kekesjtu/hfss-agent-project3/output/README.md

# 当前交付物

当前候选为 [Project3_fabrication_R3](Project3_fabrication_R3/README_制造状态.md)。目录包含原生 PCB、HFSS 工程与导出数据、制造文件、装配模型、采购清单及自包含生成脚本。

裸板上传包为 [Project3_R3_JLC_Gerber.zip](Project3_fabrication_R3/Project3_R3_JLC_Gerber.zip)，完整操作见 [购买清单与网页图解](Project3_fabrication_R3/立创商城购买清单.md)，工艺要求见 [PCB 订购说明](Project3_fabrication_R3/PCB_订购说明.md)。板厂回签与首板实测尚未完成，不能直接视为生产放行。
