kekesjtu/hfss-agent-project3/output/Project3_fabrication_R3/BOM.csv

Reference | Quantity | Manufacturer | MPN | Description | Assembly
J1 | 1 | Wurth Elektronik | 60312202114509 | 50 ohm SMA female end launch; 1.6 mm PCB | Solder center and four ground feet; no stencil
