kekesjtu/hfss-agent-project3/output/Project3_fabrication_R3/assembly.step

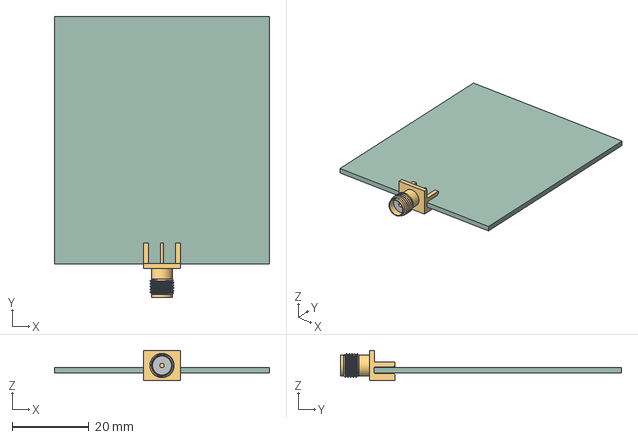
[picture p15: CAD file, 2026-11-02]
output/Project3_fabrication_R3/assembly.step
56.0 x 73.2 x 7.92 mm
60312202114509_transformed
Project3_array_R3_PCB
