kekesjtu/hfss-agent-project3/output/Project3_fabrication_R3/board_mechanical.step

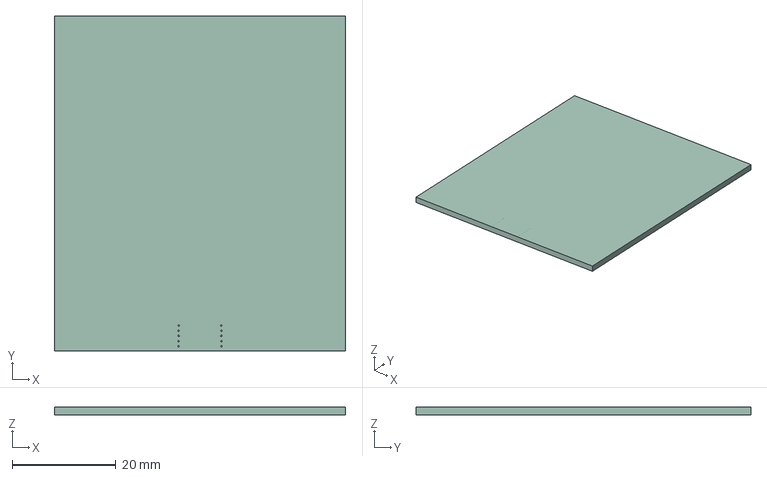
[picture p16: CAD file, 2026-11-02]
output/Project3_fabrication_R3/board_mechanical.step
56.0 x 64.4 x 1.52 mm
