kekesjtu/hfss-agent-project3/output/Project3_fabrication_R3/FABRICATION_NOTES.md

# Project3 R3 加工技术要求

状态：制造资料齐备，DRC/CAM 与完整 SMA 名义模型检查通过；板厂叠层/工艺尚未回签。指标与限制见 [最新模型核验报告](../../docs/Project3_最新模型核验报告.md)。

## 板型与叠层

依据 `docs/04 RF circuit design - projects 2026.pdf` 第 12 页的表格，而非仅按旁边的概述文字。矩形四层 FR4，外形 **56.000 × 64.430 mm**，名义成品板厚 **1.6 mm**。RF 设计材料参数 εr=4.4、tanδ=0.02；这是课件近似参数，需板厂提供实际材料/压合数据供核验。

| 自顶向下 | 厚度/mm | 材料与功能 |
|---|---:|---|
| F.Cu / L1 | 0.0350 | 天线、馈线、SMA 顶面焊盘 |
| PP1 | **0.2104** | FR4，7628×1，关键 RF 介质 |
| In1.Cu / L2 | 0.0152 | 连续 RF 参考地，四边退铜至少 0.5 mm |
| Core | 1.0650 | FR4 芯板 |
| In2.Cu / L3 | 0.0152 | 仅接地过孔焊环；不增加整面铜 |
| PP2 | 0.2104 | FR4，7628×1 |
| B.Cu / L4 | 0.0350 | SMA 底面接地焊盘与过孔焊环 |

表内厚度合计 **1.5862 mm**，与课件“1.6 mm”名义值不同；请板厂说明成品板厚的定义、阻焊/表面处理和压合公差。不得通过改变 PP1 来凑足总厚。连接器卡板部位建议控制在 1.60±0.05 mm，板厂须确认能否实现；超出此范围应先核对连接器装配，不应自动套用普通板厚公差。

## 输入匹配结构

本版输入边延长 12.260mm，采用两段串联的印刷匹配线，自连接器朝天线方向为：连接器侧宽 1.276mm、长 5.266mm；天线侧宽 3.000mm、长 3.394mm。长度基准是连接器 5.6mm 信号焊盘的内端至 T 分叉中心，名义总长 8.660mm；与焊盘有 0.01mm 的铜重叠以保证连通。两贴片、U 槽和功分分支受保护区域铜形差异为 0。加工必须保留 Gerber 的实际宽度与阶跃位置。

## 铜、阻焊与表面处理

保留实际 Gerber 线宽/间隙，不进行全局阻抗线宽修正。最窄 RF 匹配线为 0.210 mm；嵌入馈线侧隙 0.250 mm，U 槽宽 0.300 mm。天线与功分网络均为功能图形，不能当作装饰铜或孤岛删除。

首板表面处理采用 **无铅 OSP**，其工艺适用性由板厂回签。HFSS 未单独建立表面处理膜层，首板实测用于验证实际性能。原天线区域顶面整体开窗，新增输入匹配段单独开窗，连接器安装延长区按焊盘开窗；不应在天线铜或原天线区域自动加阻焊。底面按 B.Mask 制作。丝印在底面，不跨连接器焊盘。请勿未经确认改成厚镍底层的工艺后仍沿用现有 RF 预测。

不增添铜皮平衡、工艺字、二维码或测试焊盘到板内空白区域；这些可能改变天线环境。工艺边、拼板连接和工具孔如有需要，放在单板外，由板厂提交拼板图确认。单板无安装孔。

## 板边与钻孔

普通铜到铣边保持 **0.5 mm**；实际导出 L2 铜界限为 (0.5005, 0.5005) 至 (55.4995, 63.9295) mm。只有 J1 的五个表面焊盘（一个信号、四个地焊盘）按厂家端接式焊盘图到达输入板边 y=64.430 mm。

J1 的边缘露铜是端接连接器所需的结构；请确认板厂接受沿此边铣切并露铜。**不要求侧壁电镀、金手指或倒角**。KiCad 的专用规则只对 J1 焊盘允许 -0.05 mm 的检查间距，用于处理 Edge.Cuts 线宽及接触判定；普通铜仍由独立的 0.5 mm 规则约束。未使用 DRC 违规排除条目。已通过负向对照证实普通铜靠近板边仍会报错。

10 个贯通电镀接地过孔，成品孔径 **0.300 mm**，铜焊盘外径 **0.600 mm**，连接 L1/L2/L3/L4 的同一 GND 网。Excellon 文件与 Gerber 使用相同绝对原点、毫米单位。孔坐标与 KiCad 原生板逐项核对一致。不需要盲孔、埋孔、槽孔或非金属化孔。

## 连接器与装配

J1：**Würth Elektronik 60312202114509**，50 Ω SMA 母头，适用 1.6 mm 板厚。封装按厂家第 1 页推荐焊盘图生成：信号焊盘 0.9×5.6 mm；两侧地焊盘各 1.65×5.6 mm，中心相对信号中心为 ±4.125 mm；底面还有对应的两个地焊盘。不得仅因接口都是 SMA 就替换为其他卡板型号。

装配基准为输入板边与连接器中心线 x=28.000 mm。连接器向板外伸出，焊接中心针及上下两面的四个地脚；GND 地脚通过 10 个过孔与 L2 地相连。RF 与 GND 不应短路。装配使用厂家认可的温度曲线/夹具工艺，具体焊料和流程交由装配方确认。`placement.csv` 是 KiCad 的原点与角度定义；该端接连接器不是普通平面贴装件，装配时应以尺寸图和板边基准复核。

ANT1 是 PCB 铜形成的天线功能图形，不是需要采购/贴装的元器件。其自定义焊盘使 KiCad 能检查实际 RF 电气连通；BOM 只采购 J1。`board_mechanical.step` 只包含带孔板体；`assembly.step` 包含官方 SMA 三维实体，可供机械装配核对，关键尺寸仍以厂家尺寸图为准。五个焊盘与厂家官方 KiCad rev26a 封装逐项比较，坐标差为 0；STEP 模型按板边基准补偿 2.8mm 的原点差。

## 放行与测量

本地 DRC：0 违规、0 未连接；Gerber 四层及钻孔已独立回读。以上证明文件一致性，不构成板厂工艺能力确认或天线性能实测。

投板前需取得板厂对关键 PP1 厚度/材料、名义总厚与连接器卡板处厚度、外内层铜厚、OSP 和端接露铜的确认。若实际叠层不同，先按实际叠层更新电磁模型并核验。

打样后在 SMA 接口进行 VNA 校准/参考面说明，扫描至少 5.4–6.2 GHz，记录包含 5.8 GHz 的连续 -10 dB 频带；按课件要求进一步测量方向图、极化及旁瓣。预留测试照片和实测 Touchstone 数据用于仿真对照。

## 文件入口

- `Project3_array_R3.kicad_pro`：原生工程，需与 `.kicad_pcb`、`.kicad_dru` 及 `Project3_RF.pretty` 一起保存。
- `Gerber/`：四层铜、两面阻焊/丝印、外形、钻孔和钻孔图。只上传本版，不混入旧版文件。
- `BOM.csv`、`placement.csv`、`stackup.csv`：采购/装配与层叠要求。
- `connector_datasheet.pdf`：厂家尺寸图副本；核对来源为 [Würth 官方数据表](https://www.we-online.com/components/products/datasheet/60312202114509.pdf)。
- `drc.json`、`cam_validation.json`、`design_validation.json`：核查证据与放行状态。
- `fabrication_preview.png`、`connector_detail.png`：由实际 Gerber 回读生成的检查图。

复现脚本将故意违规的负向对照板写到任务 `tmp/` 目录，仅验证板边规则，不用于加工。裸板 ZIP 入口见 [PCB 订购说明](PCB_订购说明.md)。
