kekesjtu/hfss-agent-project3/output/Project3_fabrication_R3/PCB_订购说明.md

# R3 PCB 与连接器订购说明

带网页选项截图的完整教程见 [立创商城购买清单](立创商城购买清单.md)。

裸板上传 [Project3_R3_JLC_Gerber.zip](Project3_R3_JLC_Gerber.zip)。包内为 4 个铜层、2 个阻焊层、2 个丝印层、1 个板框、1 个 Excellon 钻孔文件，均放在 ZIP 根目录。加工要求以 [FABRICATION_NOTES.md](FABRICATION_NOTES.md) 和板厂回签为准。

| 下单项 | 当前设计条件 |
|---|---|
| 板材/层数/外形 | FR4、4 层、56×64.430 mm，单片出货 |
| 首板数量 | 建议 5 片，实际数量按订单确认 |
| 总厚 | 名义 1.6 mm，SMA 卡板处目标 1.60±0.05 mm |
| 叠层 | 课件对应 JLC04161H-7628；PP1/PP2 各 0.2104 mm，芯板 1.065 mm；供应商适用性待回签 |
| 外/内铜 | 35 µm / 15.2 µm，不能只用 oz 标签代替实际厚度确认 |
| 表面处理 | 首板采用无铅 OSP；表面处理工艺由板厂回签，实物性能待测 |
| 钻孔 | 10 个 0.30 mm 贯通电镀接地孔，焊环外径 0.60 mm |
| 阻焊/丝印 | 严格按文件，天线与馈线开窗；不加板内二维码/工艺字 |
| 加工约束 | 保持铜形与线宽，不统一调整阻抗线宽；L3 不加整面铜或铜平衡 |
| 装配 | 无钢网/自动 SMT 要求；SMA 中心针和上下四地脚按板边基准装配 |

J1 端接焊盘需允许铣边露铜，无侧壁电镀、半孔、金手指或倒角要求。关键 PP1 不能用于补足总板厚。板厂确认实际 Dk/Df、压合厚度、铜厚、OSP、卡板厚度与板边工艺后，手动审阅生产稿。

零件按 [BOM.csv](BOM.csv)：每板 1 个 Würth Elektronik **60312202114509**，50 Ω SMA 母头、1.6 mm 卡板。ANT1 不采购。立创商城编号 **C5514713**，[商品页](https://item.szlcsc.com/6430867.html)。2026-11-03 核对：含税单价 ¥27.18，现货 0、需订货；5 板建议购 6 个，页面货款 ¥163.08，实际价格与交期以订单确认为准。不得仅凭 SMA 接口相同替换型号。

HFSS 采用铜导体，未单独建立表面处理膜层；OSP 首板须测量 S11、方向图、极化与旁瓣。当前制造放行状态仍为 false。
