kekesjtu/hfss-agent-project3/output/Project3_fabrication_R3/CAD_MODEL_SOURCES.md

# 官方 CAD 来源

型号：Würth Elektronik 60312202114509。模型与库由厂家提供，其权利与使用条件归厂家；项目中的几何核对不改变这些条件。

- [产品系列与下载入口](https://www.we-online.com/en/components/products/COAX_SMA_CONNECTOR_PCB_END_LAUNCH)
- [KiCad WR-SMA rev26a](https://www.we-online.com/components/products/download/KiCad_WR-SMA%20%28rev26a%29.zip)：本地三维模型采用库中的 `J_Wurth_WR-SMA_60312202114509.step`。五个铜焊盘的几何比较见 `vendor_footprint_validation.json`。
- [Ansys rev25a](https://www.we-online.com/components/products/download/ANSYS_60312202114509%20%28rev25a%29.a3dcomp)：官方加密组件，采用 HFSS Terminal Network 类型；按支持的方式插入和放置，未解密或修改内部模型。
- [独立 STEP rev1](https://www.we-online.com/components/products/download/Download_STP_60312202114509%20%28rev1%29.stp)：作为厂家机械模型来源留存。
- [厂家 Ansys 使用指南](https://www.we-online.com/files/pdf1/ug018a_user_mannuel_we_ansys_library-v1.pdf)
- [厂家 Ansys 库及许可文件](https://github.com/WurthElektronik/Ansys-Library)

厂家下载模型受其许可条款约束，条款截图为 `vendor_model_terms.png`。模型可能存在简化，不能据此免除实际装配、板厂工艺和射频实测核对。
