kekesjtu/hfss-agent-project3/output/Project3_fabrication_R3/HFSS_full_SMA/MODEL_SCOPE.md

# R3 完整 SMA 模型范围

官方 Würth rev25a Terminal Network 加密组件保持完整，包含外壳、绝缘体、中心针和外接口波端口。PCB 含 35um 顶铜实体、15.2um L2 铜、上下部 FR4、L3 焊环、底面地焊盘及 10 个中空贯通铜孔；模型孔壁厚 0.025mm。没有磁对称约束。实际 RF 顶面铜已与原生板进行几何配准。

模型孔及过孔焊环采用 16 边形近似圆周；16 边形在 0.3mm 最大半径处的径向误差不超过 0.00577mm。PCB 加工文件仍是圆形 0.3mm 成品孔和 0.6mm 焊环，不把多边形近似写进生产钻孔。该曲面近似、25um 孔壁铜与真实焊点均有模型误差。导体采用铜材料，未单独建立 OSP 膜层或表面镀银层；首板采购的 OSP 工艺性能需实测。

焊料采用 tin 矩形近似：上地脚间隙 0.05mm，下地脚间隙 0.0938mm；中心针下方间隙 0.43mm，使用针尾端 0.22mm 长、0.74mm 宽、0.62mm 高的端部焊角连接，未填满整段针底。机械 STEP 是厂家干装模型，不用它定义实际焊料形状。未建立阻焊/丝印介质实体；天线和馈线按制造开窗设计。L2 退边取 0.5mm 名义值，Gerber 填充取整为 0.5005mm。

空气域名义余量 20mm，外接口处边界与厂家波端口重合。其余外边界与实际组件的最小间距约 15.6mm；边界/网格不确定性需要结合数值对照解释，不能把几何间距合格等同于边界误差为零。

FR4 参数 εr=4.4、tanδ=0.02 为课件名义值。未进行批次材料、压合、蚀刻、连接器安装和焊点的统计公差分析；需要板厂实际叠层与首板 VNA/方向图测量。原始终端参数文件保留；分析副本仅将列名归一成 P1，数值不变。
