kekesjtu/hfss-agent-project3/output/Project3_fabrication_R3/connector_detail.png

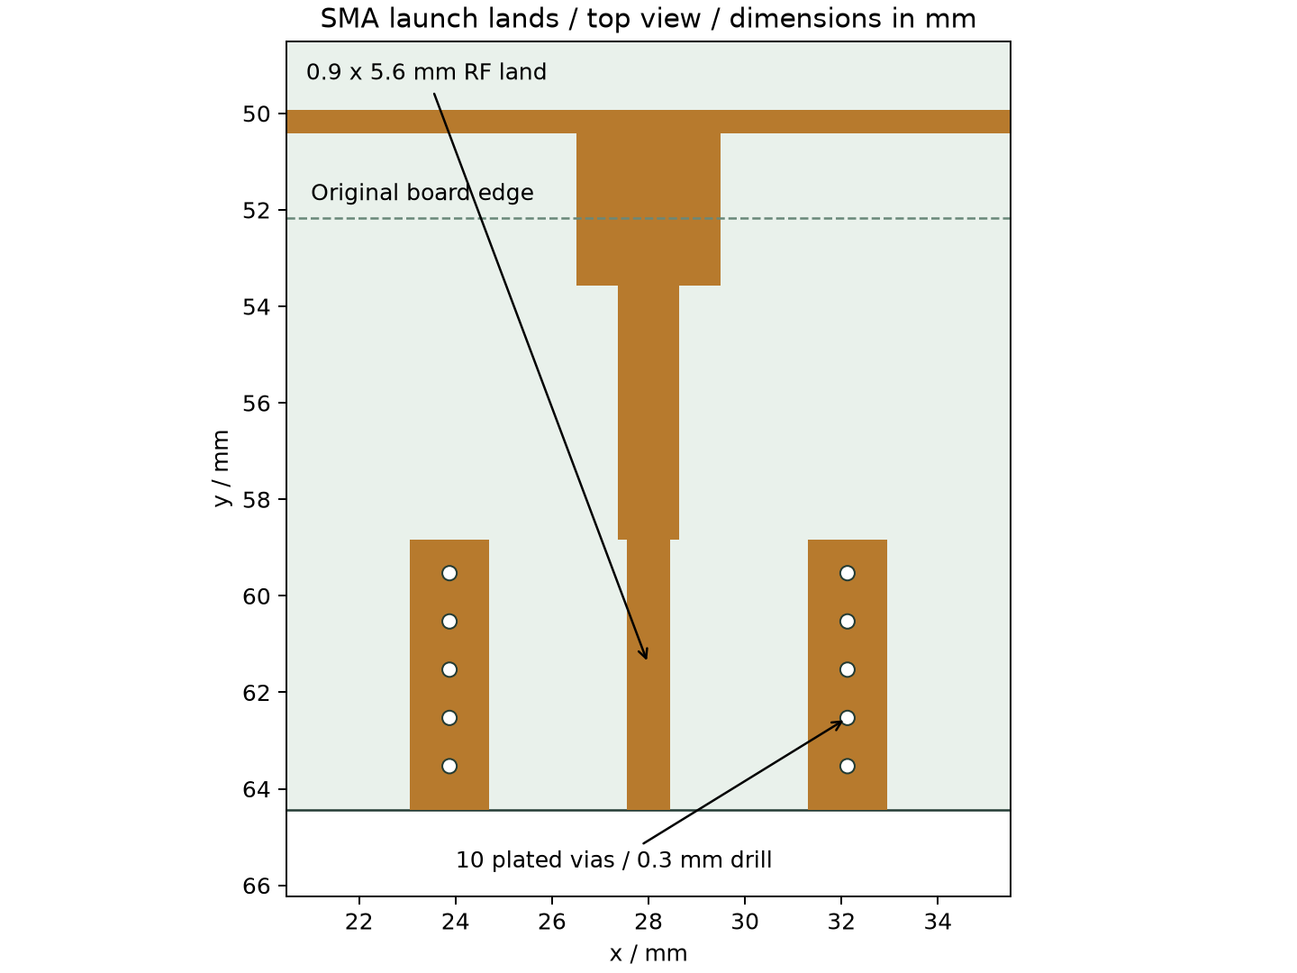
output/Project3_fabrication_R3/connector_detail.png
