kekesjtu/hfss-agent-project3/output/Project3_fabrication_R3/vendor_model_terms.png

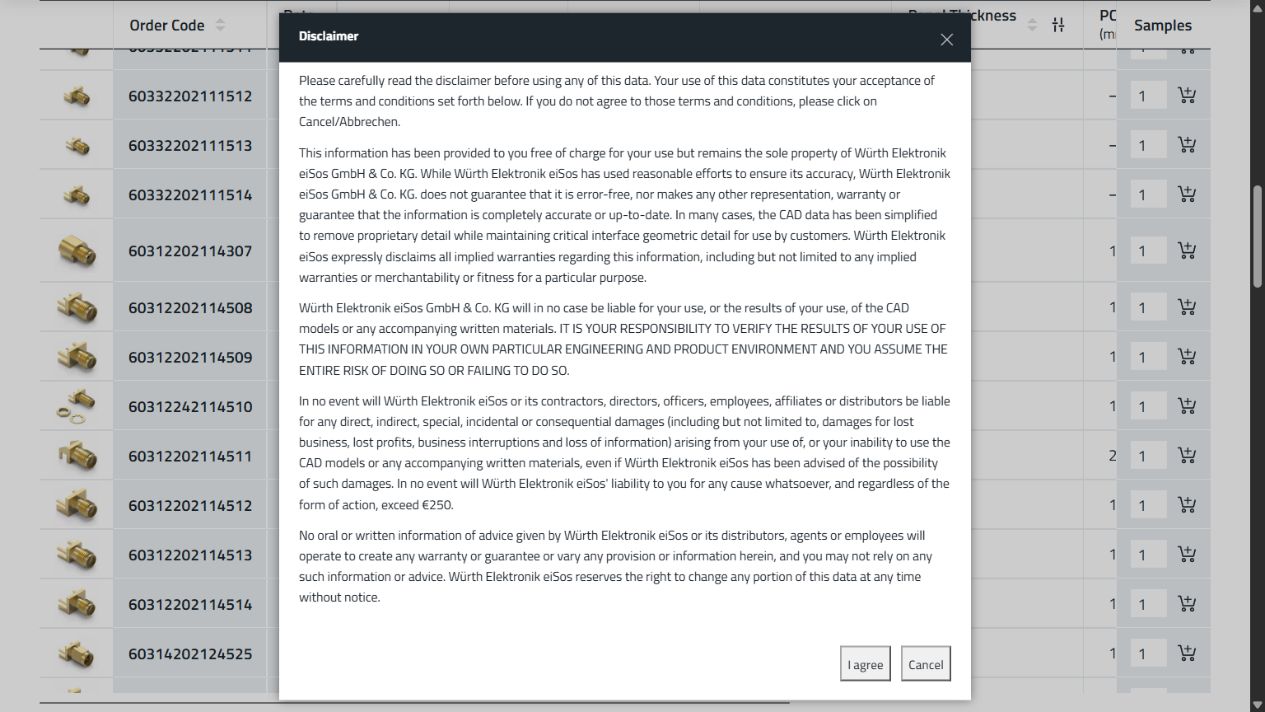
output/Project3_fabrication_R3/vendor_model_terms.png
