kekesjtu/hfss-agent-project3/(commit log)

2026-11-02 Initialize organized Project3 R3 delivery and reproducible tooling
    [BOM.csv, Project3_array.kicad_pcb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]
2026-11-02 Add illustrated JLC purchase guide and align OSP fabrication settings
    [Project3_array_R3.kicad_pcb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]
